GICM-UdeA/seven-ch-multimeter/DAFNE_TEST_v1-3/LUT_ADC.c

const float LUT_AIN1[4096]={
0.108,0.109,0.110,0.111,0.112,0.113,0.113,0.114,0.115,0.116,0.117,0.118,0.119,0.119,0.120,0.121,0.122,0.123,0.124,0.125,0.125,0.126,0.127,0.128,0.129,0.130,0.130,0.131,0.132,0.133,0.134,0.135,0.136,0.136,0.137,0.138,0.139,0.140,0.141,0.141,0.142,0.143,0.144,0.145,0.146,0.147,0.147,0.148,0.149,0.150,0.151,0.152,0.152,0.153,0.154,0.155,0.156,0.157,0.157,0.158,0.159,0.160,0.161,0.162,0.163,0.163,0.164,0.165,0.166,0.167,0.168,0.168,0.169,0.170,0.171,0.172,0.173,0.173,0.174,0.175,0.176,0.177,0.178,0.178,0.179,0.180,0.181,0.182,0.183,0.183,0.184,0.185,0.186,0.187,0.188,0.188,0.189,0.190,0.191,0.192,0.193,0.193,0.194,0.195,0.196,0.197,0.198,0.198,0.199,0.200,0.201,0.202,0.203,0.203,0.204,0.205,0.206,0.207,0.208,0.208,0.209,0.210,0.211,0.212,0.213,0.213,0.214,0.215,0.216,0.217,0.218,0.218,0.219,0.220,0.221,0.222,0.223,0.223,0.224,0.225,0.226,0.227,0.227,0.228,0.229,0.230,0.231,0.232,0.232,0.233,0.234,0.235,0.236,0.237,0.237,0.238,0.239,0.240,0.241,0.242,0.242,0.243,0.244,0.245,0.246,0.246,0.247,0.248,0.249,0.250,0.251,0.251,0.252,0.253,0.254,0.255,0.256,0.256,0.257,0.258,0.259,0.260,0.260,0.261,0.262,0.263,0.264,0.265,0.265,0.266,0.267,0.268,0.269,0.269,0.270,0.271,0.272,0.273,0.274,0.274,0.275,0.276,0.277,0.278,0.279,0.279,0.280,0.281,0.282,0.283,0.283,0.284,0.285,0.286,0.287,0.288,0.288,0.289,0.290,0.291,0.292,0.292,0.293,0.294,0.295,0.296,0.297,0.297,0.298,0.299,0.300,0.301,0.301,0.302,0.303,0.304,0.305,0.306,0.306,0.307,0.308,0.309,0.310,0.310,0.311,0.312,0.313,0.314,0.314,0.315,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
3.052,3.053,3.053,3.053,3.054,3.054,3.054,3.055,3.055,3.056,3.056,3.056,3.057,3.057,3.058,3.058,3.058,3.059,3.059,3.060,3.060,3.060,3.061,3.061,3.061,3.062,3.062,3.063,3.063,3.063,3.064,3.064,3.065,3.065,3.065,3.066,3.066,3.067,3.067,3.067,3.068,3.068,3.069,3.069,3.069,3.070,3.070,3.071,3.071,3.071,3.072,3.072,3.073,3.073,3.073,3.074,3.074,3.075,3.075,3.075,3.076,3.076,3.077,3.077,3.077,3.078,3.078,3.079,3.079,3.079,3.080,3.080,3.081,3.081,3.081,3.082,3.082,3.083,3.083,3.083,3.084,3.084,3.085,3.085,3.085,3.086,3.086,3.087,3.087,3.087,3.088,3.088,3.089,3.089,3.090,3.090
};
const float LUT_AIN2[4096]={
0.0156,0.0157,0.0158,0.0159,0.0160,0.0161,0.0162,0.0163,0.0164,0.0165,0.0166,0.0167,0.0168,0.0169,0.0170,0.0171,0.0172,0.0173,0.0174,0.0175,0.0176,0.0177,0.0178,0.0179,0.0180,0.0181,0.0182,0.0183,0.0184,0.0185,0.0186,0.0187,0.0188,0.0189,0.0190,0.0191,0.0192,0.0193,0.0194,0.0195,0.0196,0.0197,0.0198,0.0199,0.0200,0.0201,0.0202,0.0203,0.0204,0.0205,0.0206,0.0207,0.0208,0.0209,0.0210,0.0211,0.0212,0.0213,0.0214,0.0215,0.0216,0.0217,0.0218,0.0219,0.0220,0.0221,0.0222,0.0223,0.0224,0.0225,0.0226,0.0228,0.0229,0.0230,0.0231,0.0232,0.0233,0.0234,0.0235,0.0236,0.0237,0.0238,0.0239,0.0240,0.0241,0.0242,0.0243,0.0244,0.0245,0.0246,0.0247,0.0248,0.0249,0.0250,0.0251,0.0252,0.0253,0.0254,0.0255,0.0256,0.0257,0.0258,0.0259,0.0260,0.0261,0.0262,0.0263,0.0264,0.0265,0.0266,0.0267,0.0268,0.0269,0.0270,0.0271,0.0272,0.0273,0.0274,0.0275,0.0276,0.0277,0.0278,0.0279,0.0280,0.0281,0.0282,0.0283,0.0284,0.0285,0.0286,0.0287,0.0288,0.0289,0.0290,0.0291,0.0292,0.0293,0.0294,0.0295,0.0296,0.0297,0.0298,0.0299,0.0301,0.0302,0.0303,0.0304,0.0305,0.0306,0.0307,0.0308,0.0309,0.0310,0.0311,0.0312,0.0313,0.0314,0.0315,0.0316,0.0317,0.0318,0.0319,0.0320,0.0321,0.0322,0.0323,0.0324,0.0325,0.0326,0.0327,0.0328,0.0329,0.0330,0.0331,0.0332,0.0333,0.0334,0.0335,0.0336,0.0337,0.0338,0.0339,0.0340,0.0341,0.0342,0.0343,0.0344,0.0345,0.0346,0.0347,0.0348,0.0349,0.0350,0.0351,0.0352,0.0353,0.0354,0.0355,0.0356,0.0357,0.0358,0.0359,0.0360,0.0361,0.0362,0.0363,0.0364,0.0365,0.0366,0.0367,0.0368,0.0369,0.0370,0.0371,0.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
};
