GICM-UdeA/seven-ch-multimeter/DAFNE_TEST_v1-3/limits.c

///////////////// ENTER HERE THE LIMITS TO PASS THEST  -----------------------------+
////OHM-METER                                                                       +
#define res_low_limit 0.0 //Lower limit of the interval of acceptance [kOhm]        +
#define res_high_limit 3.2 //Higher limit of the interval of acceptance [kOhm]      +
//                                                                                  +
////DIODOE METER                                                                    +
#define dio_low_limit 100.0 //Lower limit of the interval of acceptance [mV]        +
#define dio_high_limit 380.0 //Higher limit of the interval of acceptance [mV]      +
//                                                                                  +
////VOLTMETER                                                                       +
#define vol_low_limit 300.0 //Lower limit of the interval of acceptance [mV]        +
#define vol_high_limit 3300.0 //Lower limit of the interval of acceptance [mV]      +
//////////////////-------------------------------------------------------------------
